SiLab-Bonn/BDAQ-core/README.md

# BDAQ Core board documentation 

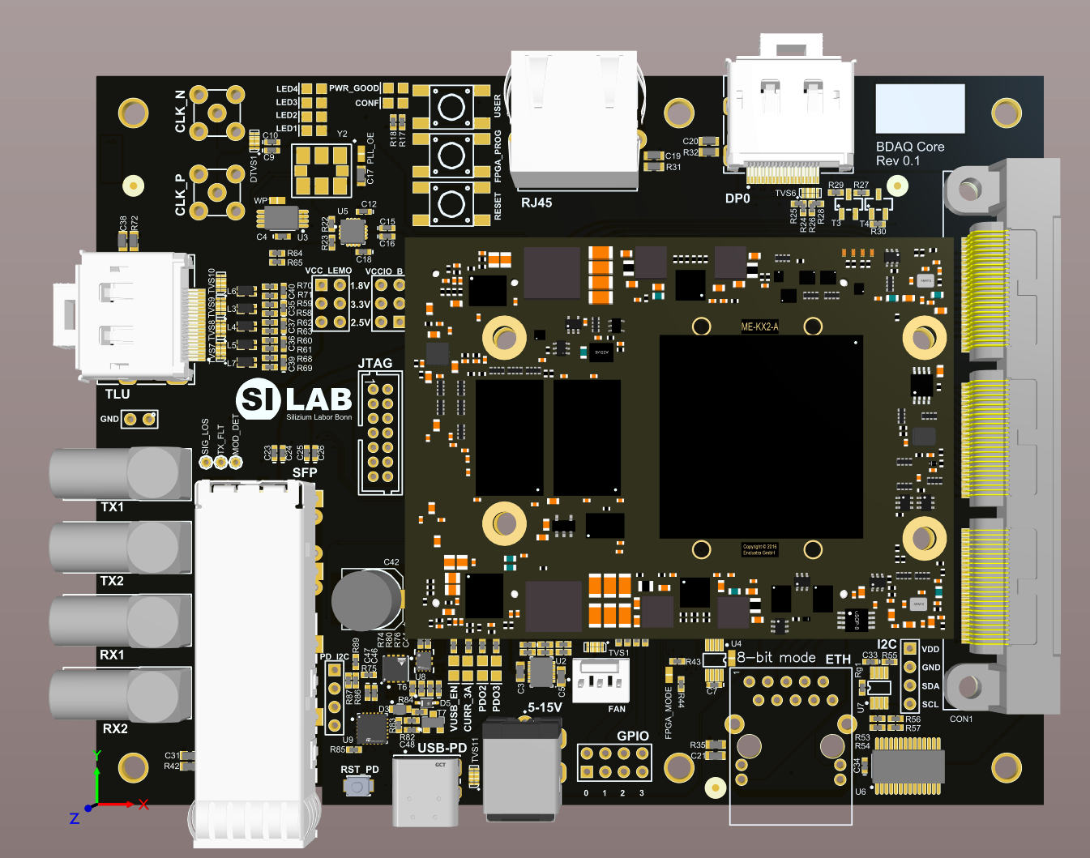
[picture p1: bdaq-core.png]
BDAQ Core board


Documentation will be made available here. The design files are accessible via the FTD Altium Cloud service.

Todo
- add/update user constraints file
- ...
