SiLab-Bonn/BDAQ-core/BDAQ Core 1.2.pdf

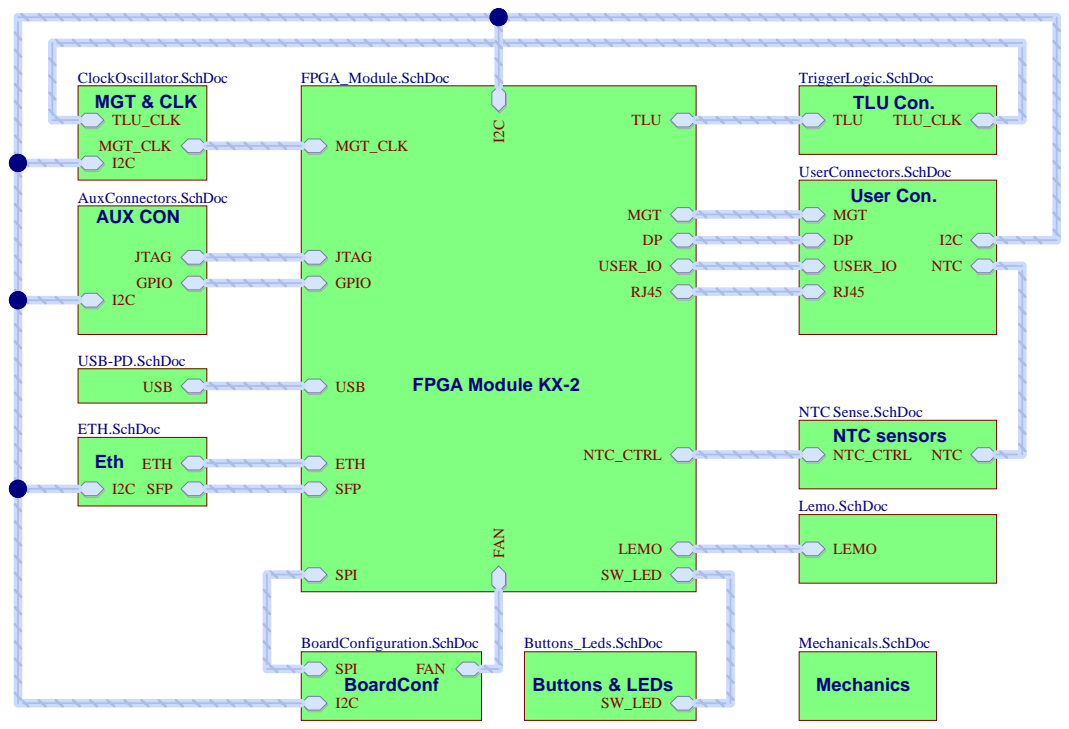
[picture p2: page 1]

Title: BDAQ Core | Physikalisches Institut UniversitätBonn Nußallee 12 53115 Bonn

Project: BDAQ Core | Drawn by:MV/HK/RL

Date: 11.09.2026 Time: 13:43:38 | Sheet of

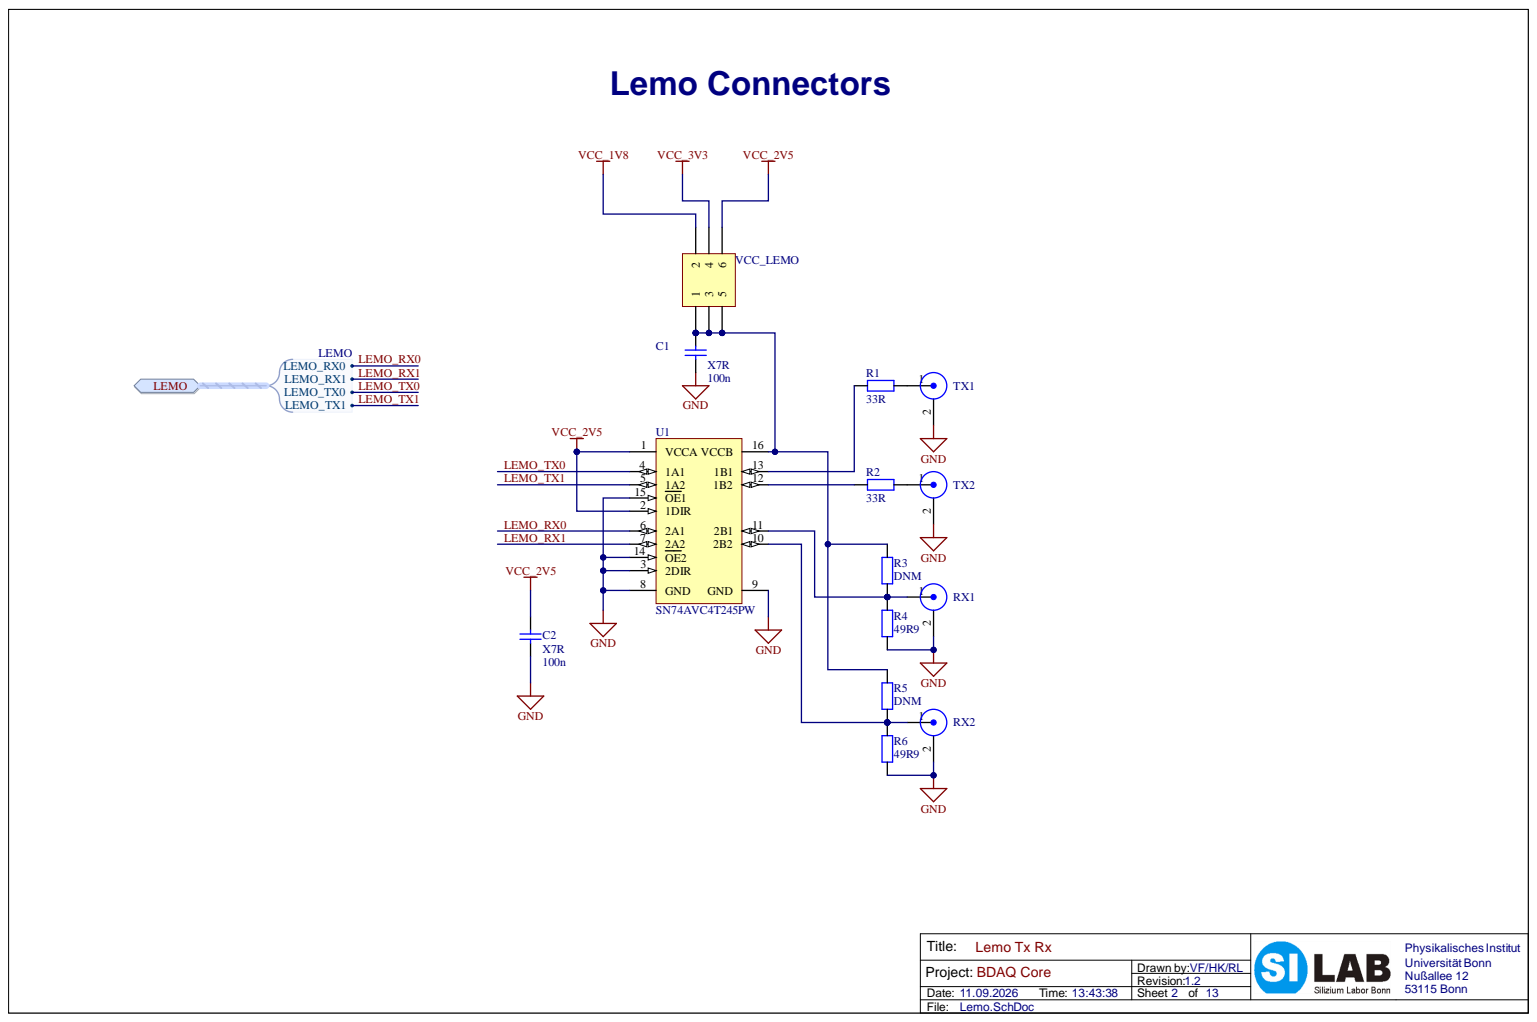
[picture p3: page 2]

Title: Date: File: P roject: BDAQ Cor e | Drawn by :VF / H K/ R L

Lemo Tx Rx | Phy sikalis ches Ins t i t u t 53115 Bonn UniversitätBonn N u ßallee 12

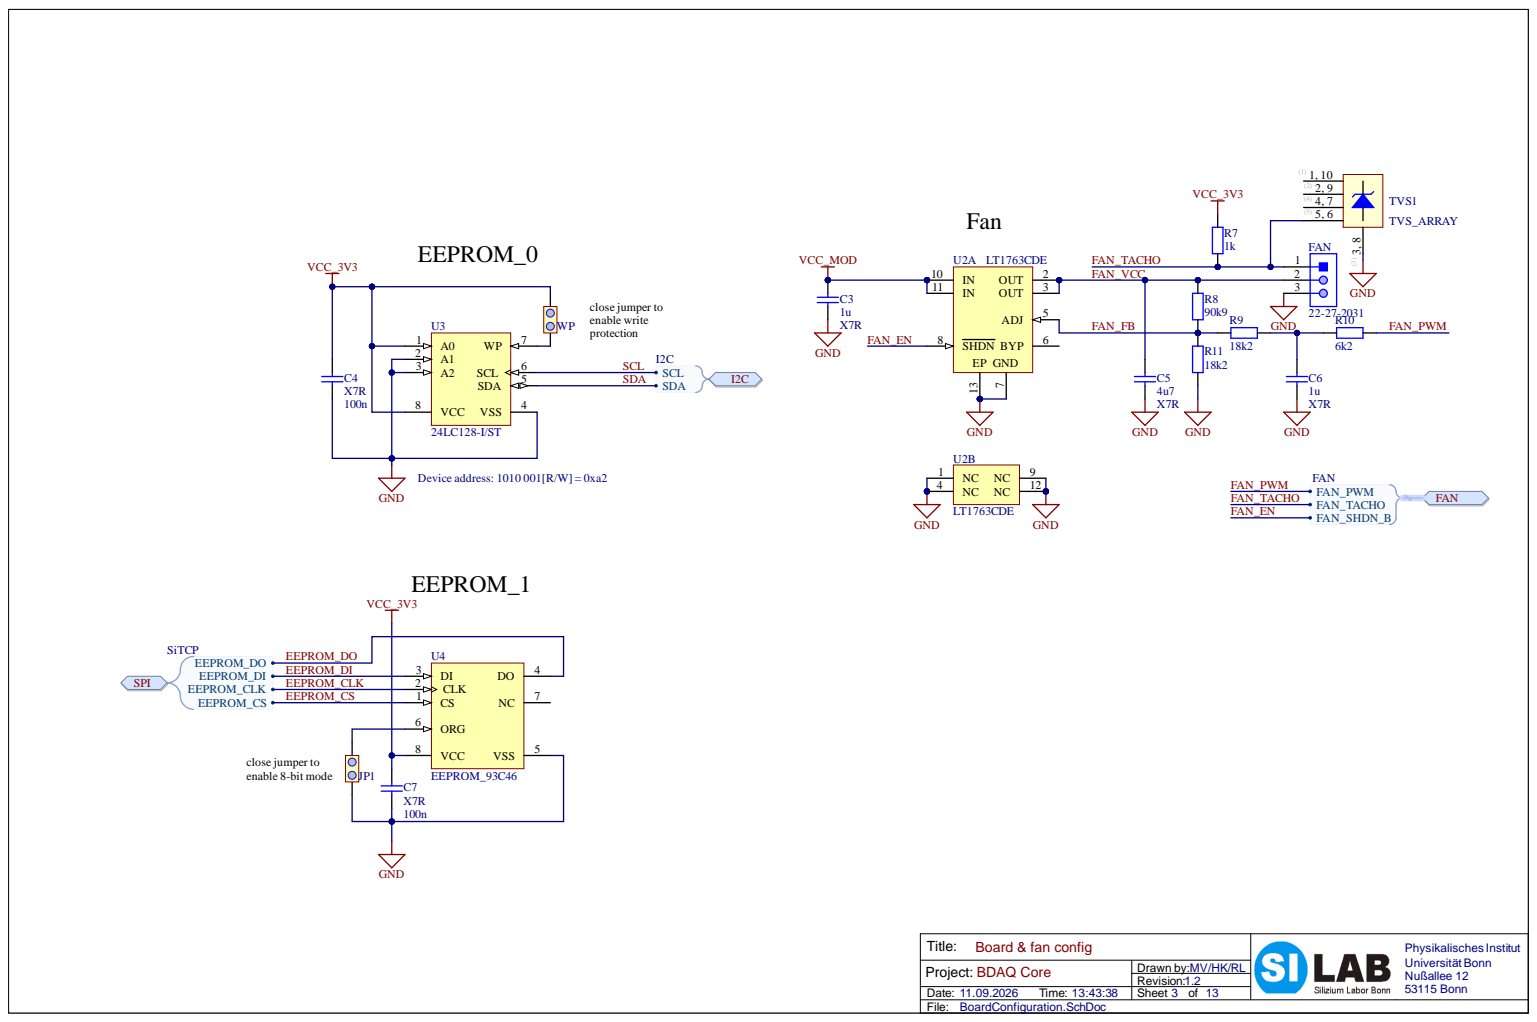
[picture p4: page 3]

Title: Board & fan config | Physikalisches Institut UniversitätBonn Nußallee 12 53115 Bonn

Project: BDAQ Core | Drawn by:MV/HK/RL

Date: 11.09.2026 Time: 13:43:38 | Sheet of

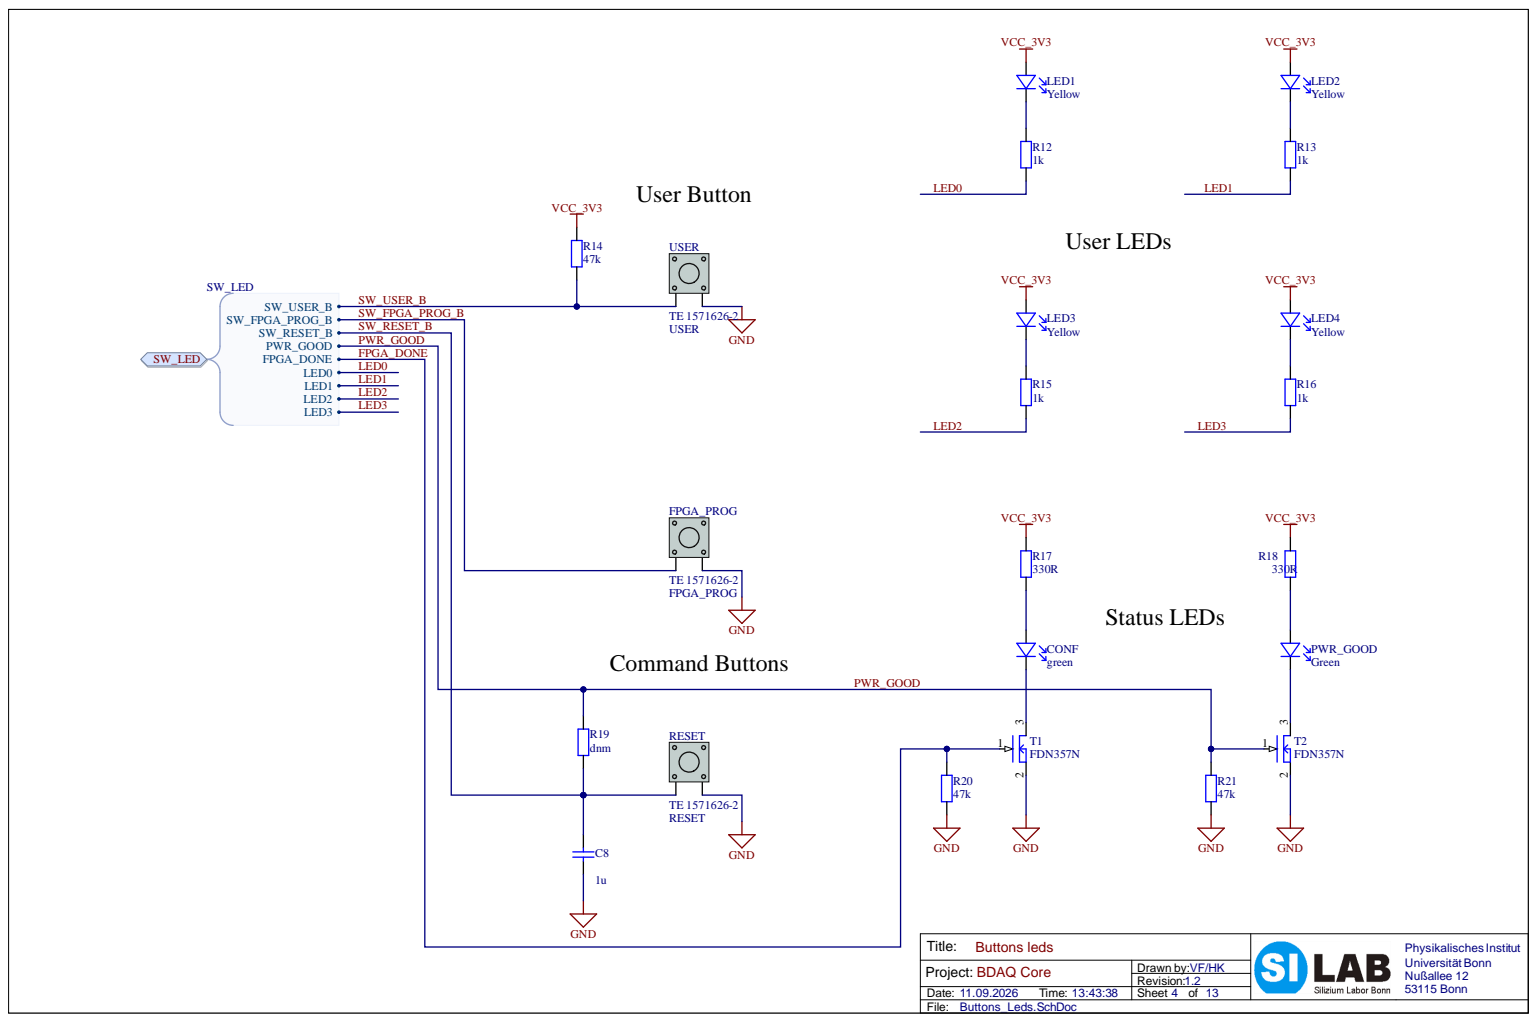
[picture p5: page 4]

Title: Date: File: P roject: BDAQ Cor e | Drawn by :VF / H K

Buttons leds | Phy sikalis ches Ins t i t u t 53115 Bonn UniversitätBonn N u ßallee 12

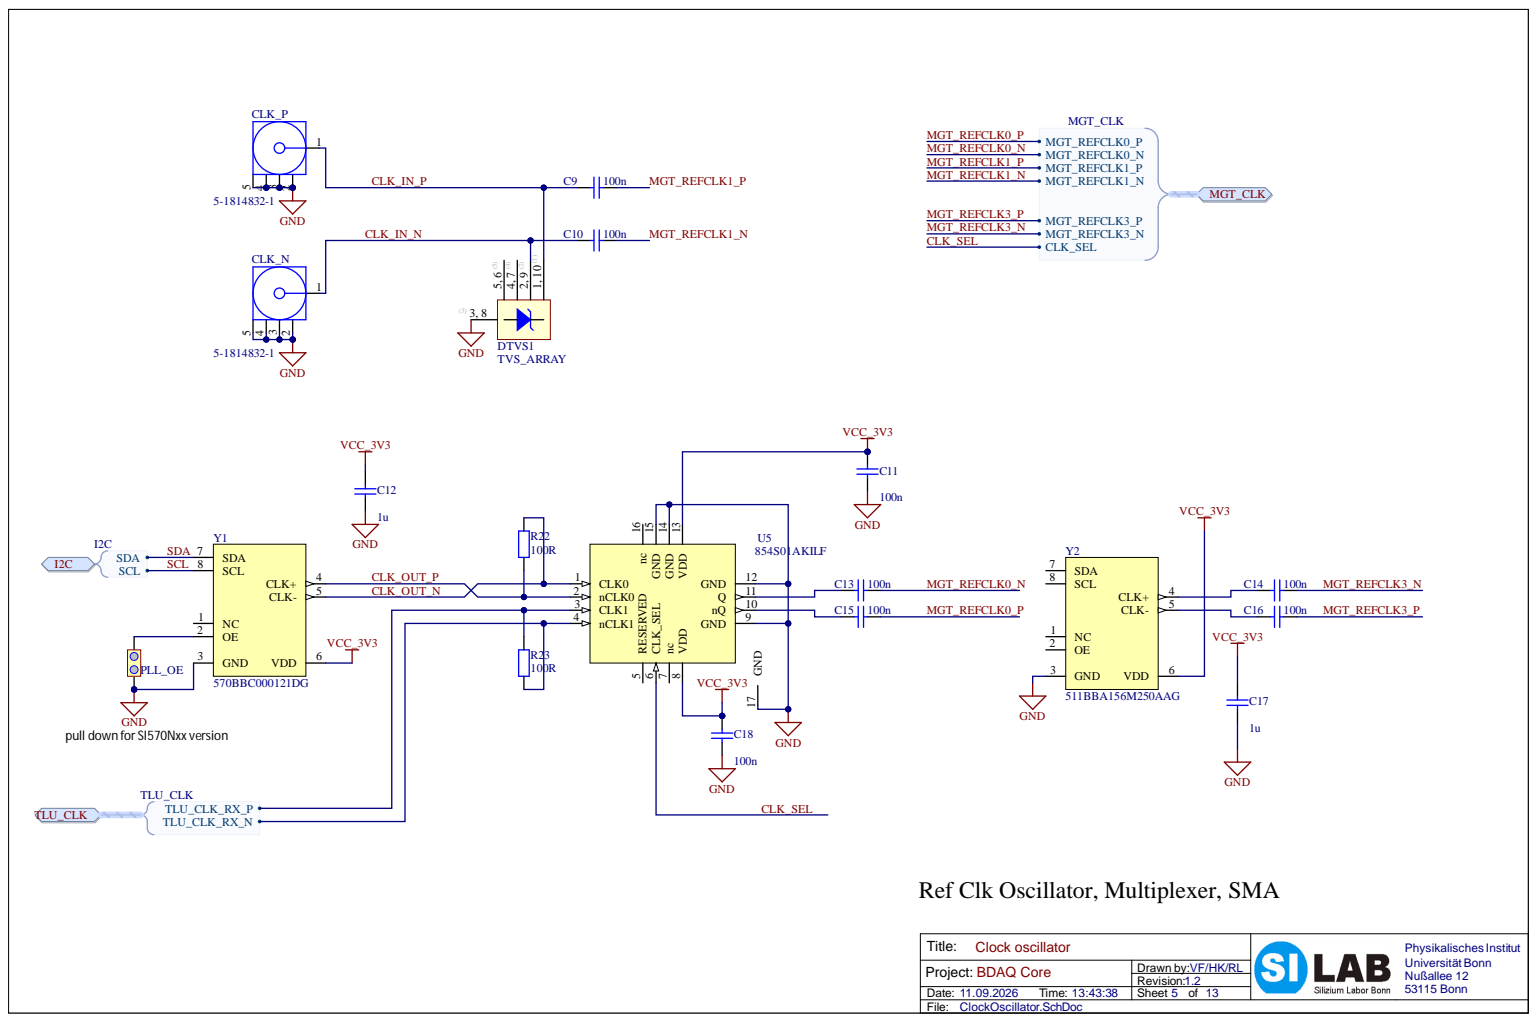
[picture p6: page 5]

12 DD 13 GND 14 GND 15 nc 16

pull down for SI570Nxx version

Ref Clk Oscillator, Multiplexer, SMA

Title: Clock oscillator | Physikalisches Institut UniversitätBonn Nußallee 12 53115 Bonn

Project: BDAQ Core | Drawn by:VF/HK/RL

Date: 11.09.2026 Time: 13:43:38 | Sheet of

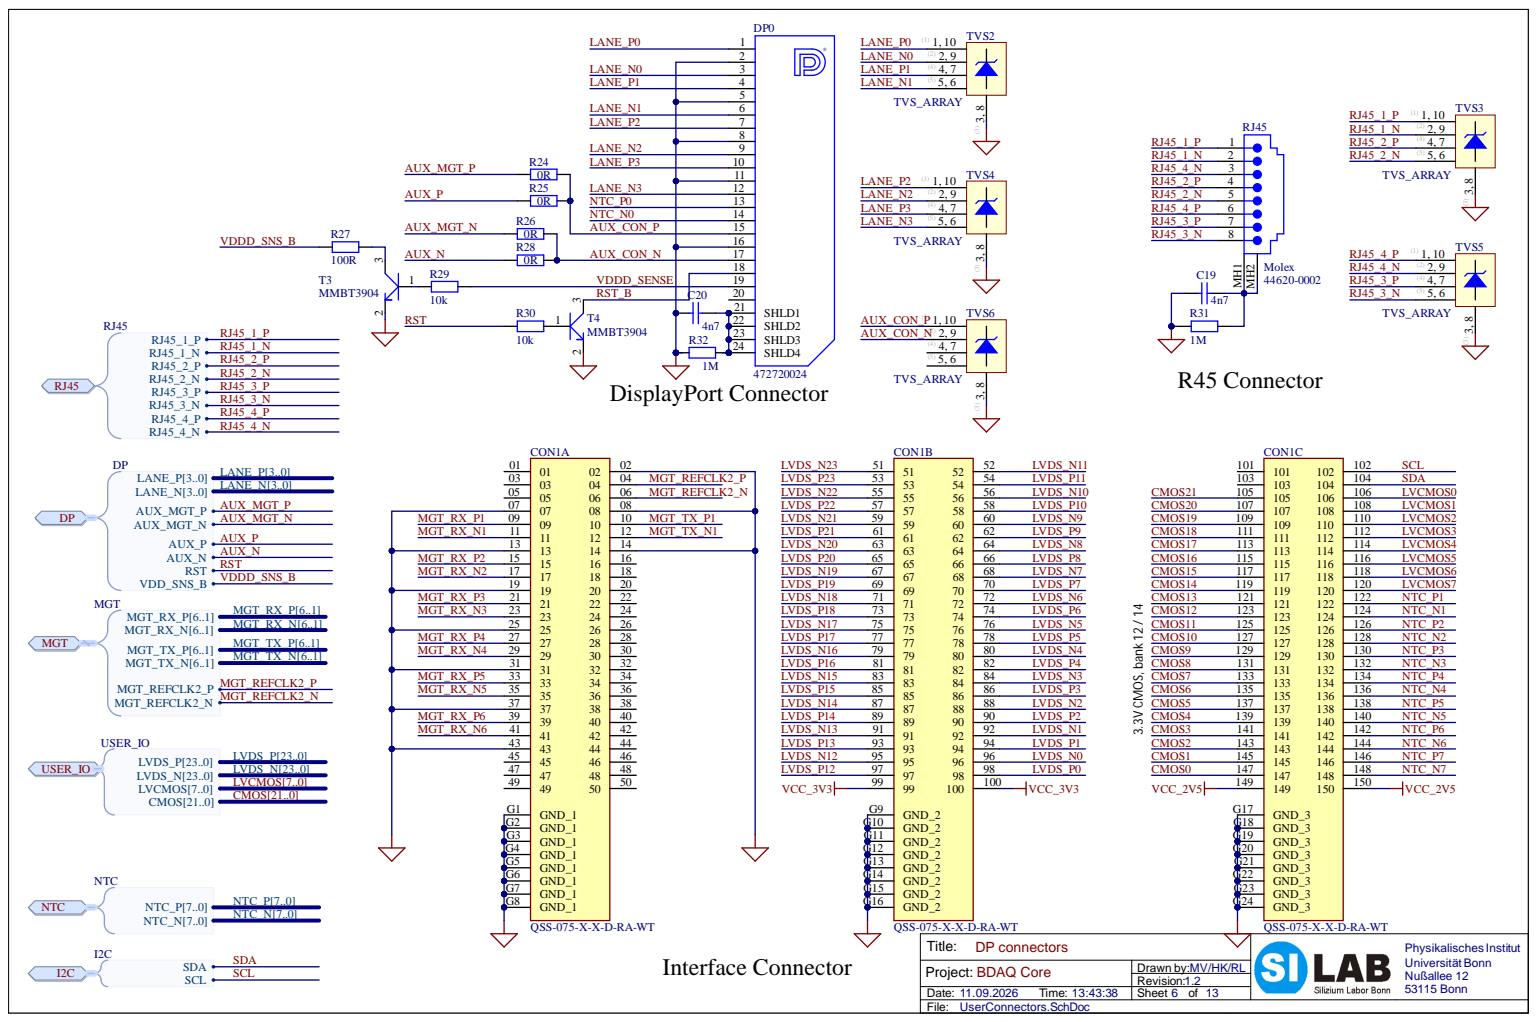
[picture p7: page 6]

1 7
1 8

V D D D _SE N S E | | 1 9
RST _B | C2 0 | 2 0

R3 | | 2 1
4 n 7 2 | 2 2

Title: Date: File: P roject: BDAQ Cor e | Drawn by : MV/ H K/ R L

DP connector s | Phy sikalis ches Ins t i t u t 53115 Bonn UniversitätBonn N u ßallee 12

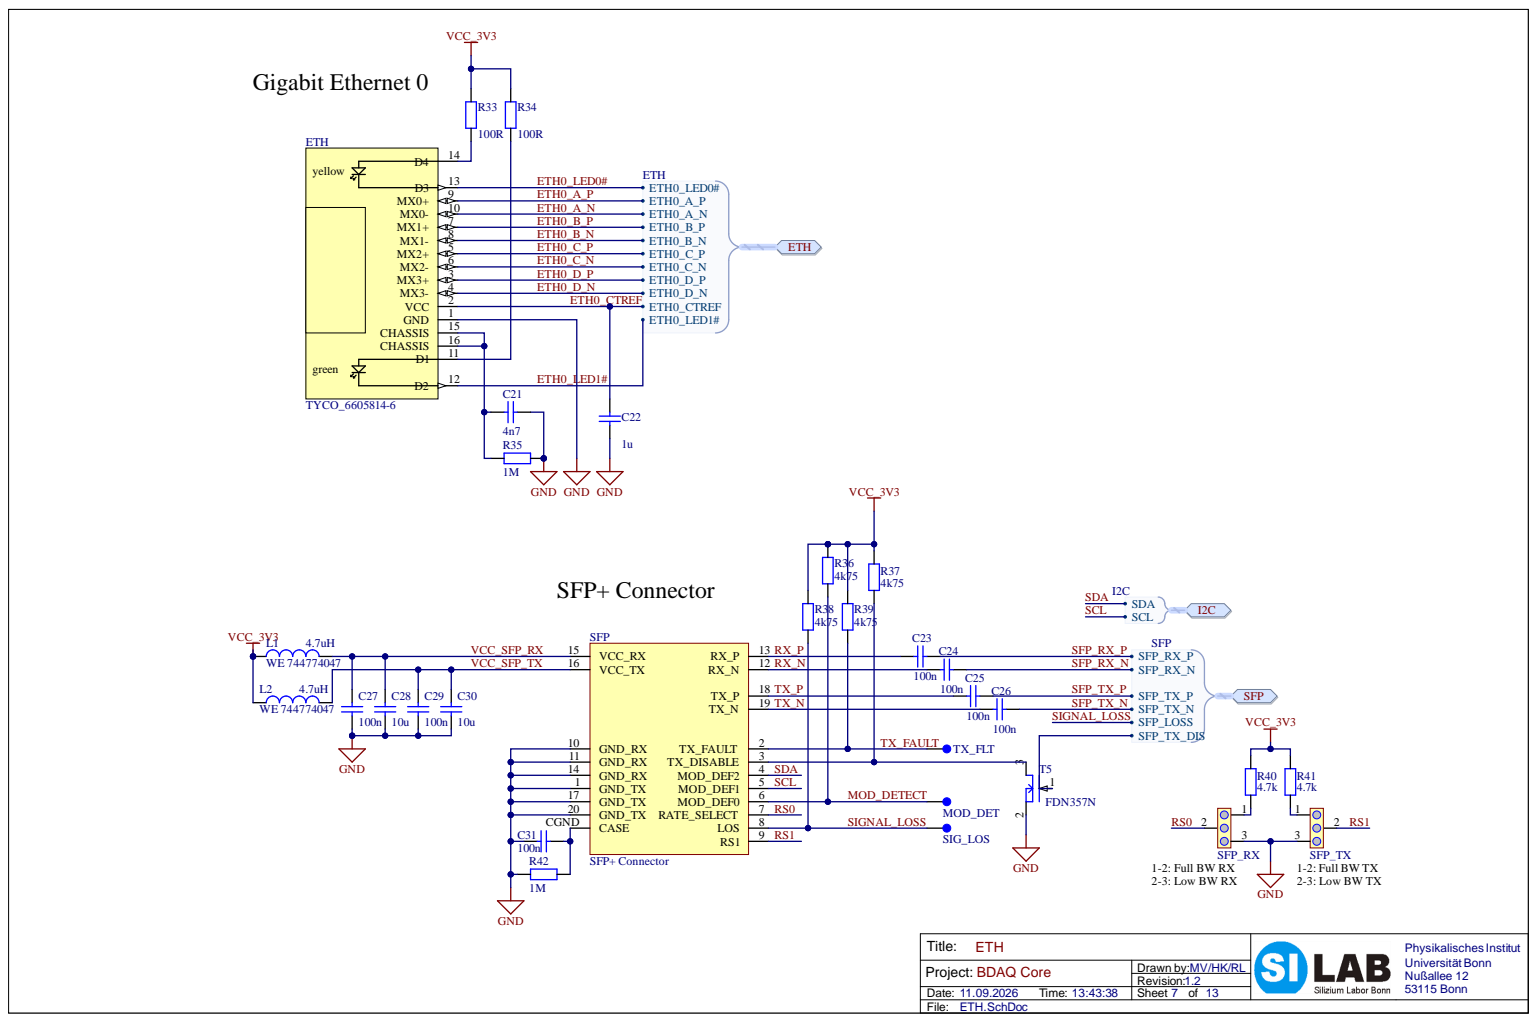
[picture p8: page 7]

yellow

ETH0_A_N
ETH0_B_P

ETH0_D_P
ETH0_D_N
ETH0_CTREF

Title: ETH | Physikalisches Institut UniversitätBonn Nußallee 12 53115 Bonn

Project: BDAQ Core | Drawn by:MV/HK/RL

Date: 11.09.2026 Time: 13:43:38 | Sheet of

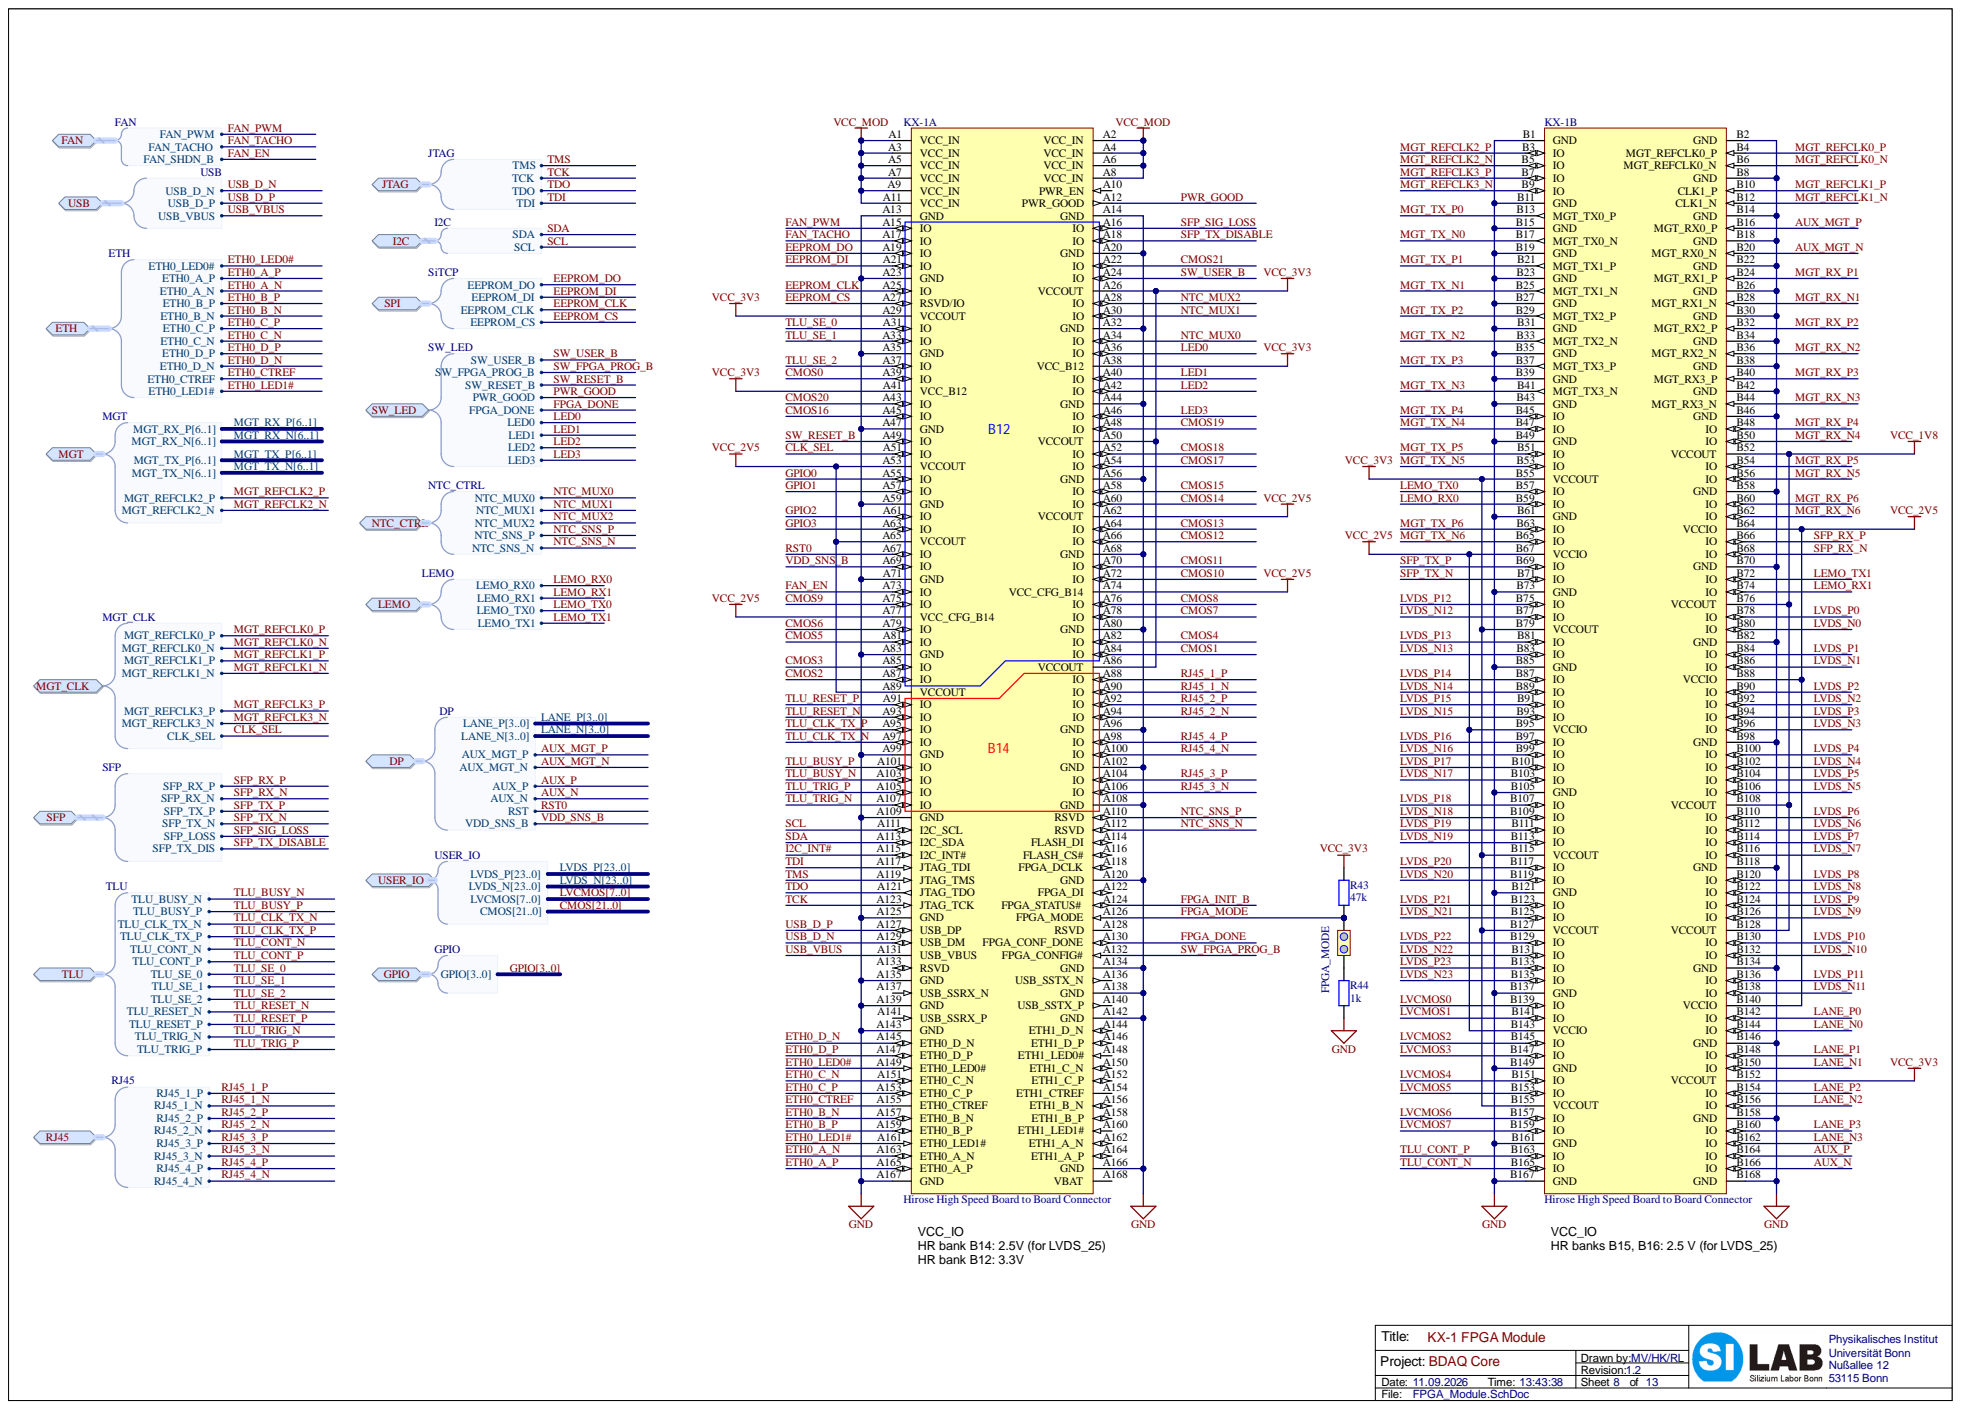
[picture p9: page 8]

A 3 | A | 4
A 5 | A | 6
A 7 | A | 8

A 9 | A10
A 1 | A12 A14

A76 A78 A80 | R J45_1_P R J45_1_N R J45_2_P R J45_2_N R J45_4_P R J45_4_N R J45_3_P R J45_3_N N T C_SNS_P N T C_SNS_N

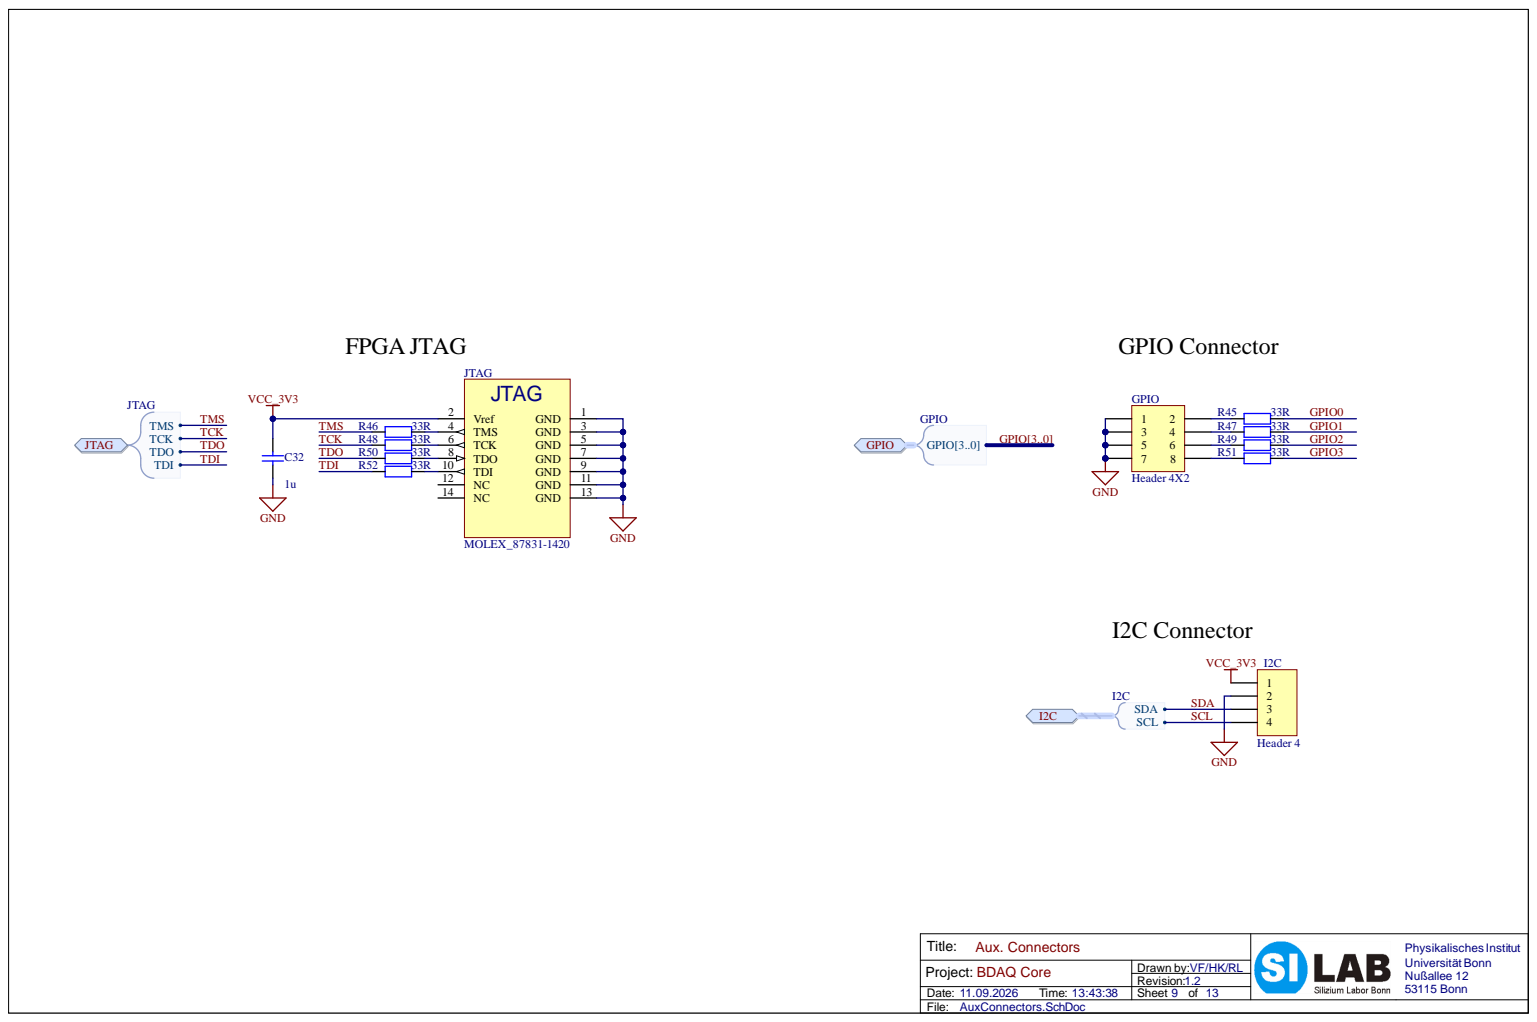
[picture p10: page 9]

Title: Aux. Connectors | Physikalisches Institut UniversitätBonn Nußallee 12 53115 Bonn

Project: BDAQ Core | Drawn by:VF/HK/RL

Date: 11.09.2026 Time: 13:43:38 | Sheet of

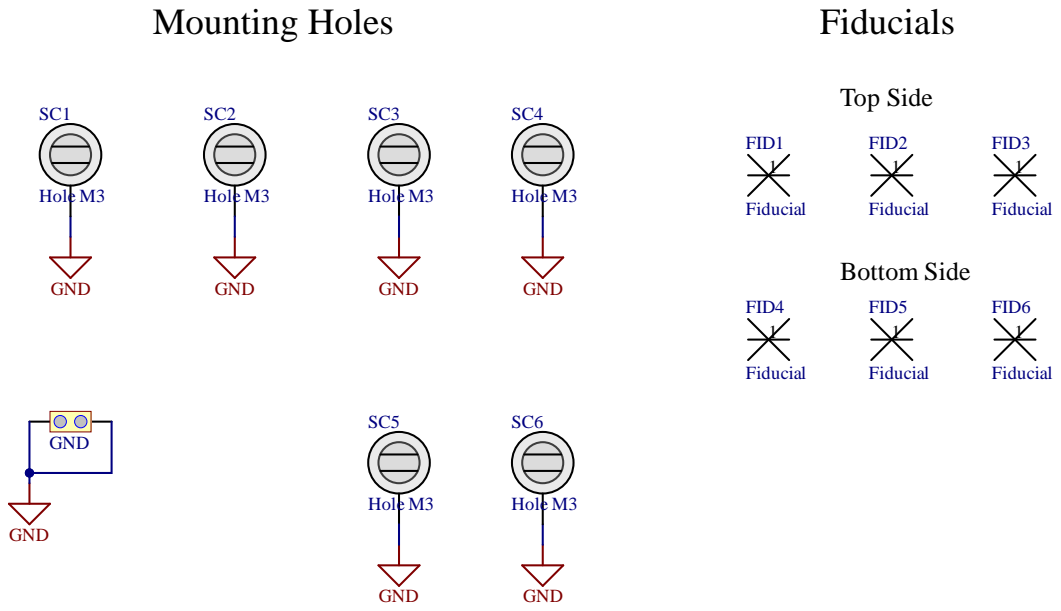
[picture p11: page 10]

Title: Mechanicals | Physikalisches Institut UniversitätBonn Nußallee 12 53115 Bonn
Project: BDAQ Core | Drawn by:VF/HK

Date: 11.09.2026 Time: 13:43:38 | Sheet of

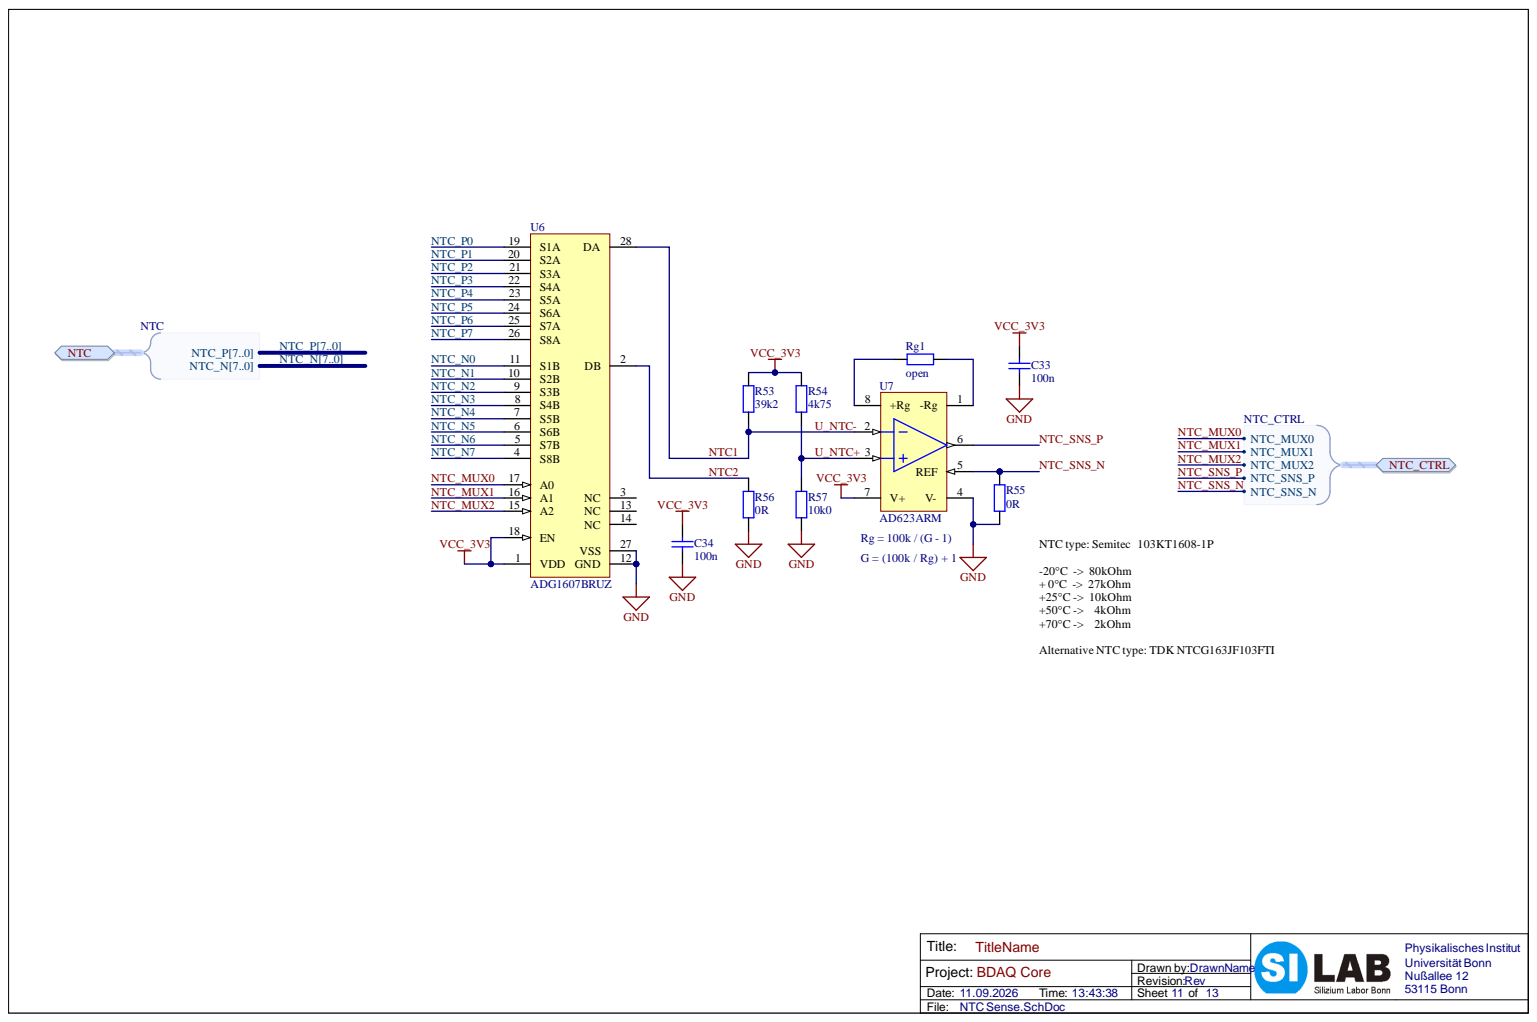
[picture p12: page 11]

Title: Date: File: P roject: BDAQ Cor e | Drawn by : DrawnN a m | e

TitleNam e | Phy sikalis ches Ins t i t u t 53115 Bonn UniversitätBonn N u ßallee 12

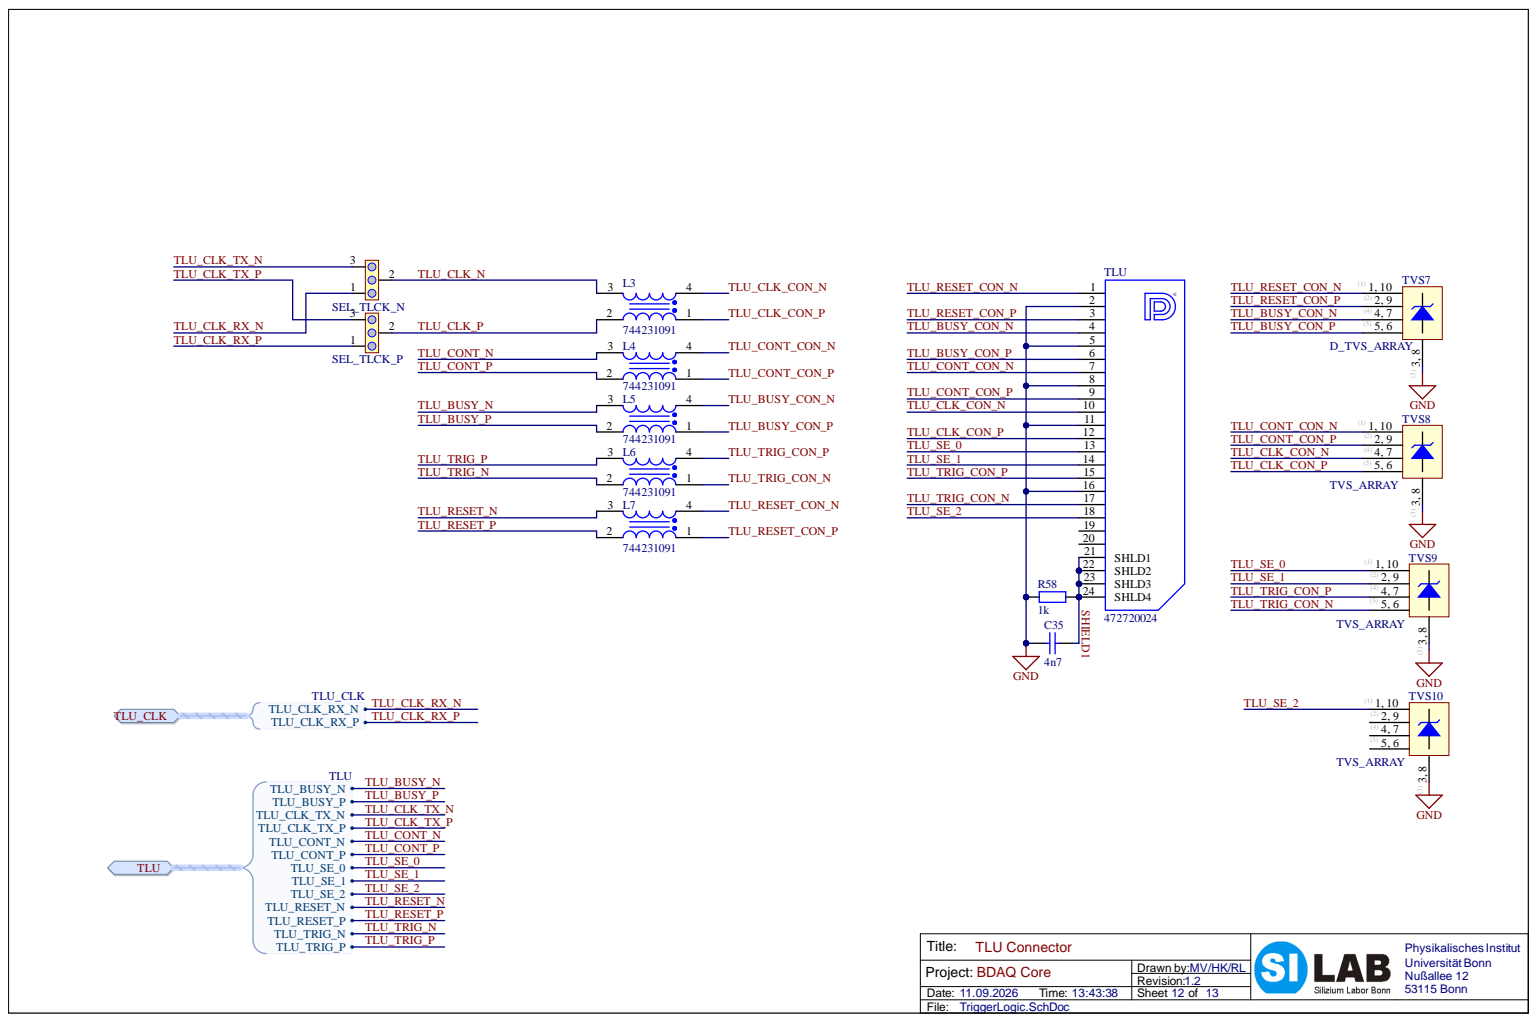
[picture p13: page 12]

Title: Date: File: P roject: BDAQ Cor e | Drawn by : MV/ H K/ R L

TLU Connector | Phy sikalis ches Ins t i t u t 53115 Bonn UniversitätBonn N u ßallee 12

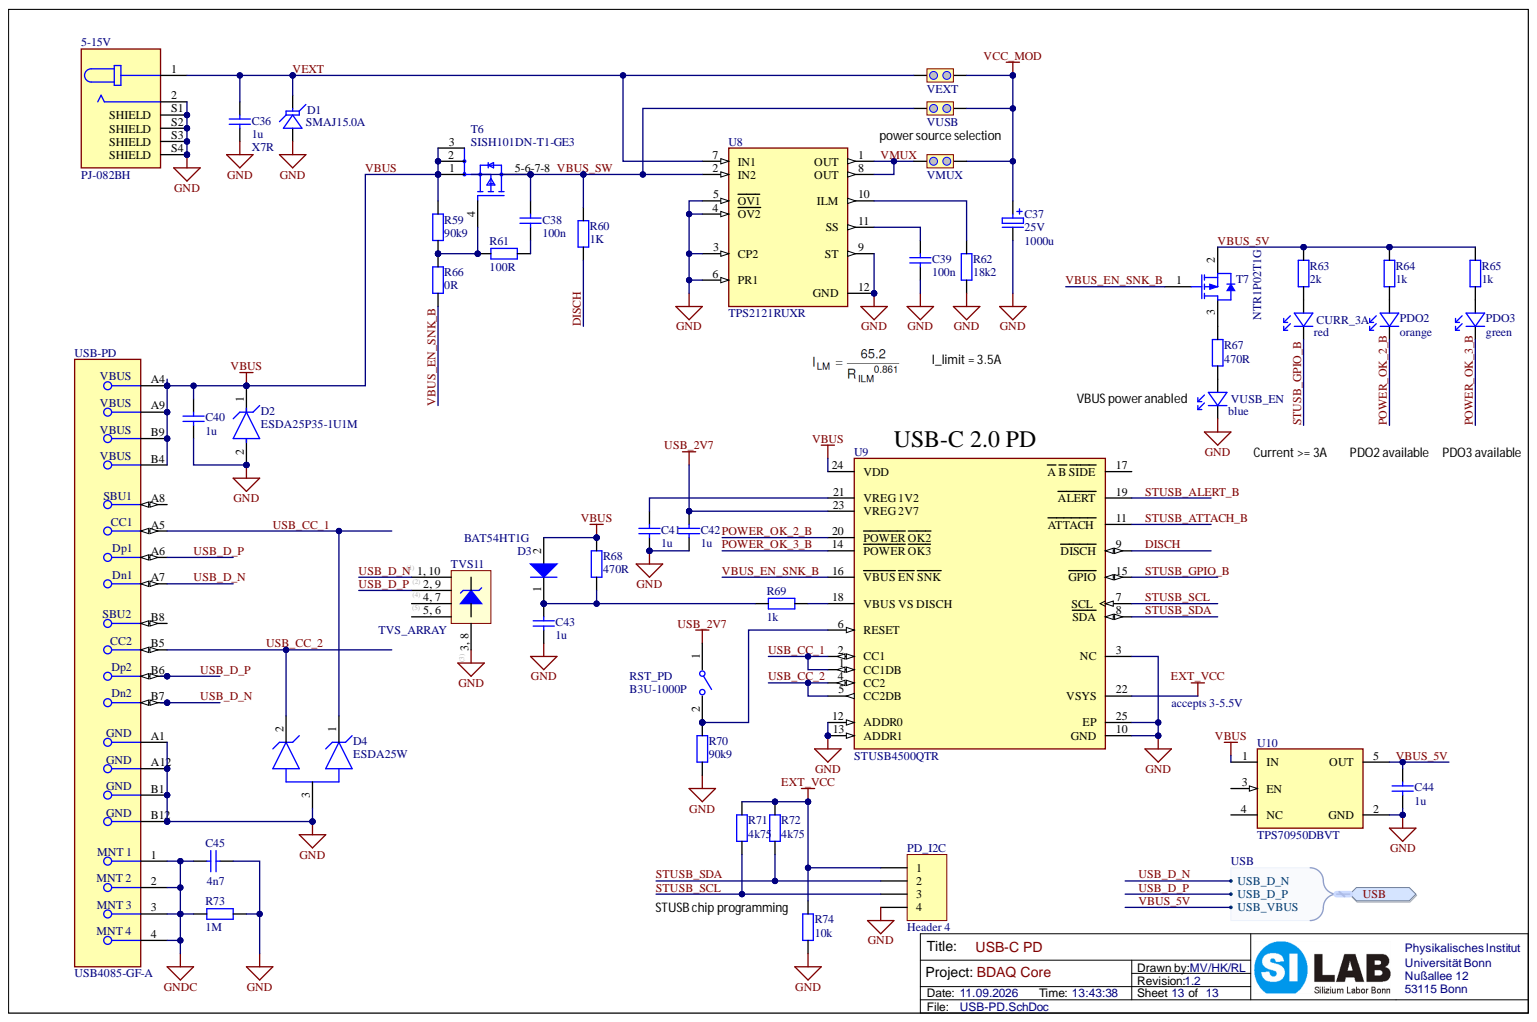
[picture p14: page 13]

Title: USB-C PD | Physikalisches Institut UniversitätBonn Nußallee 12 53115 Bonn

Project: BDAQ Core | Drawn by:MV/HK/RL

Date: 11.09.2026 Time: 13:43:38 | Sheet of

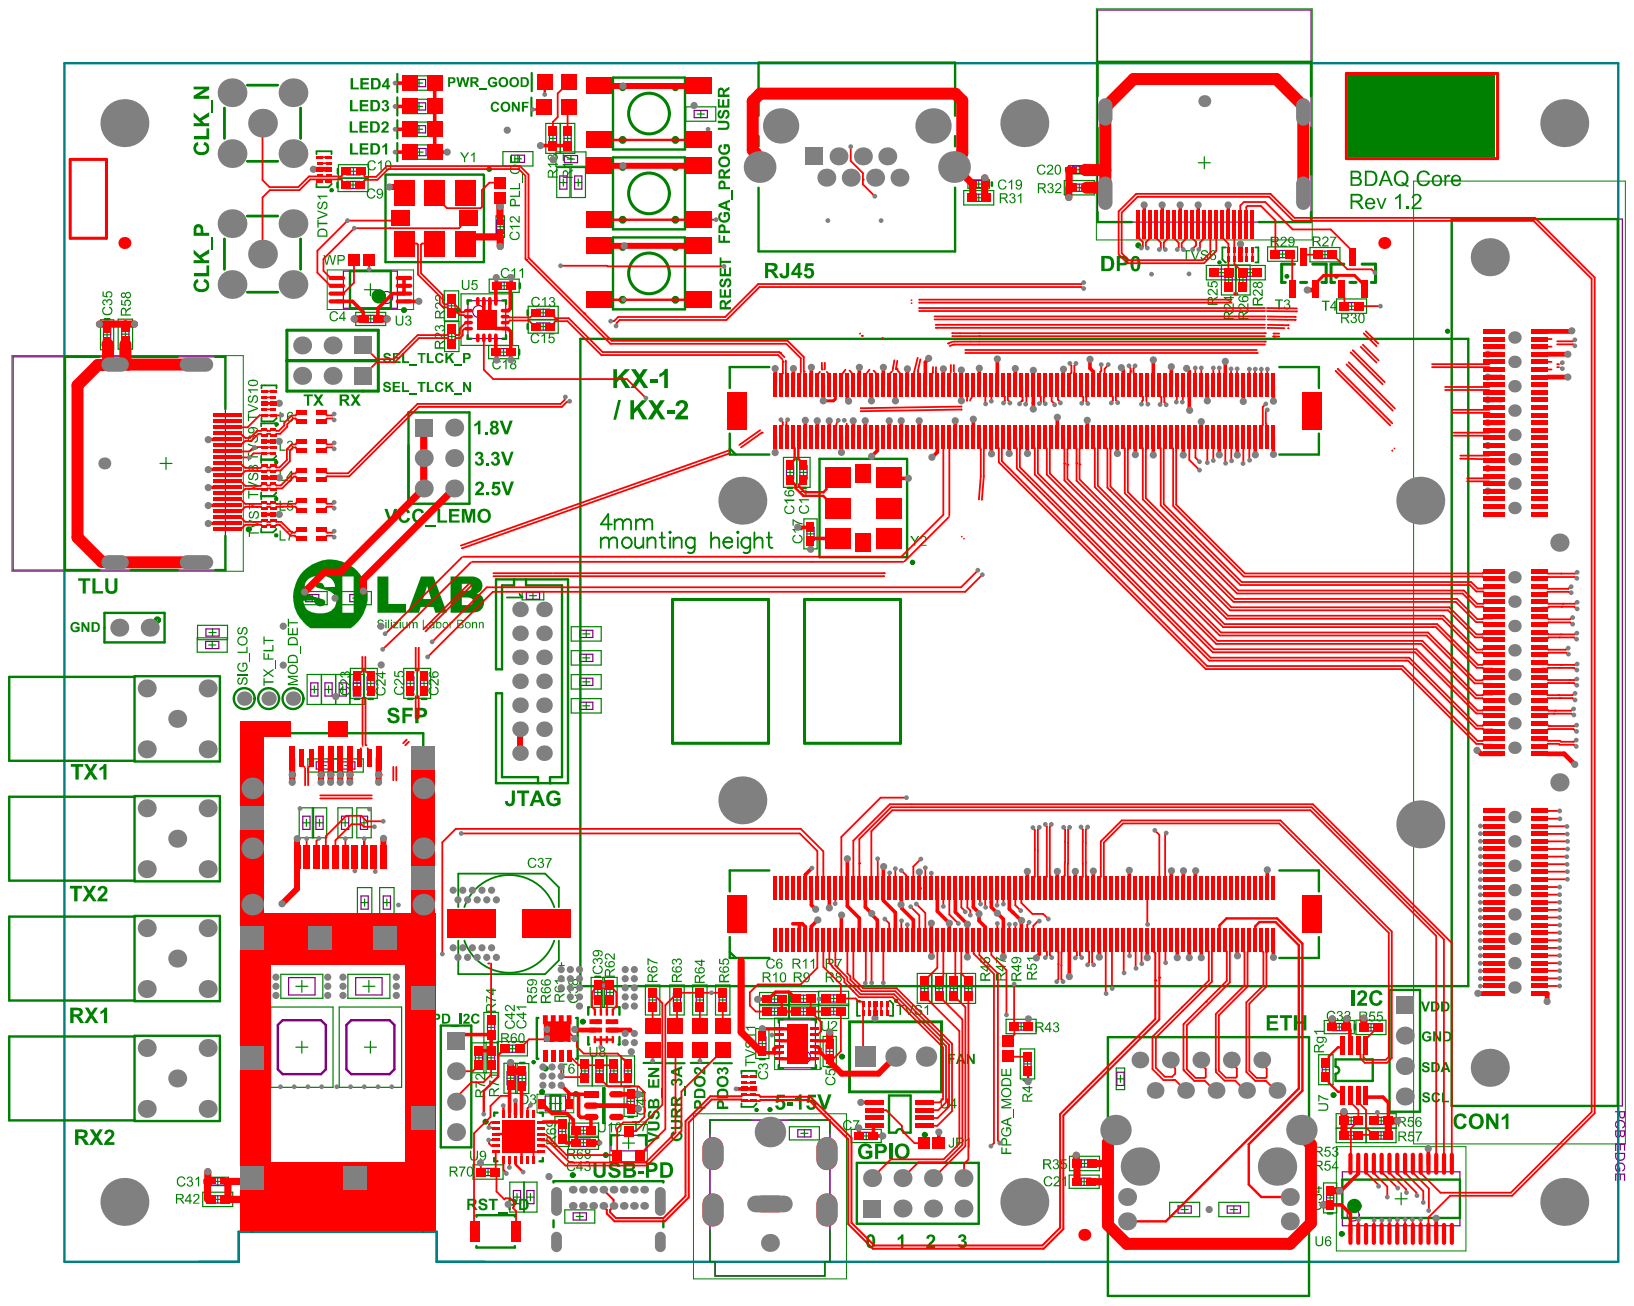
[picture p15: page 14]

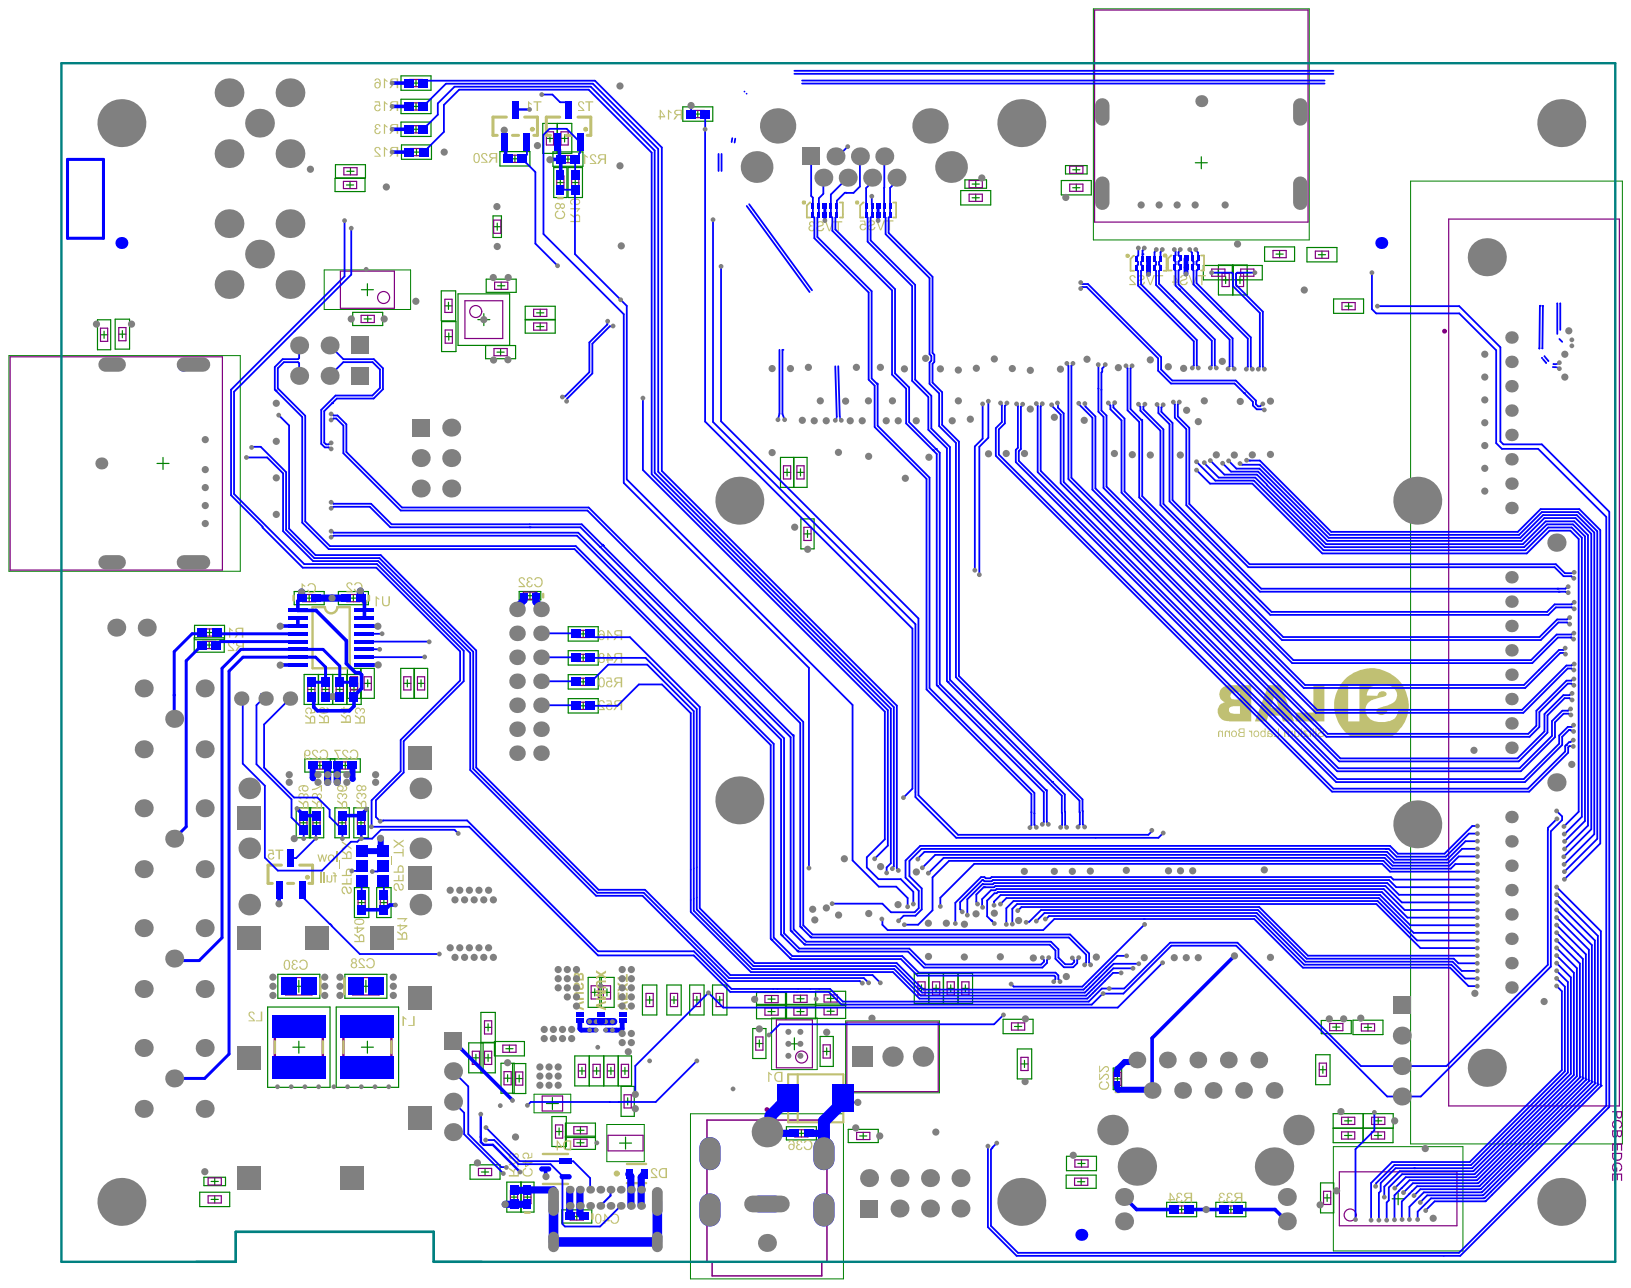
[picture p16: page 15]

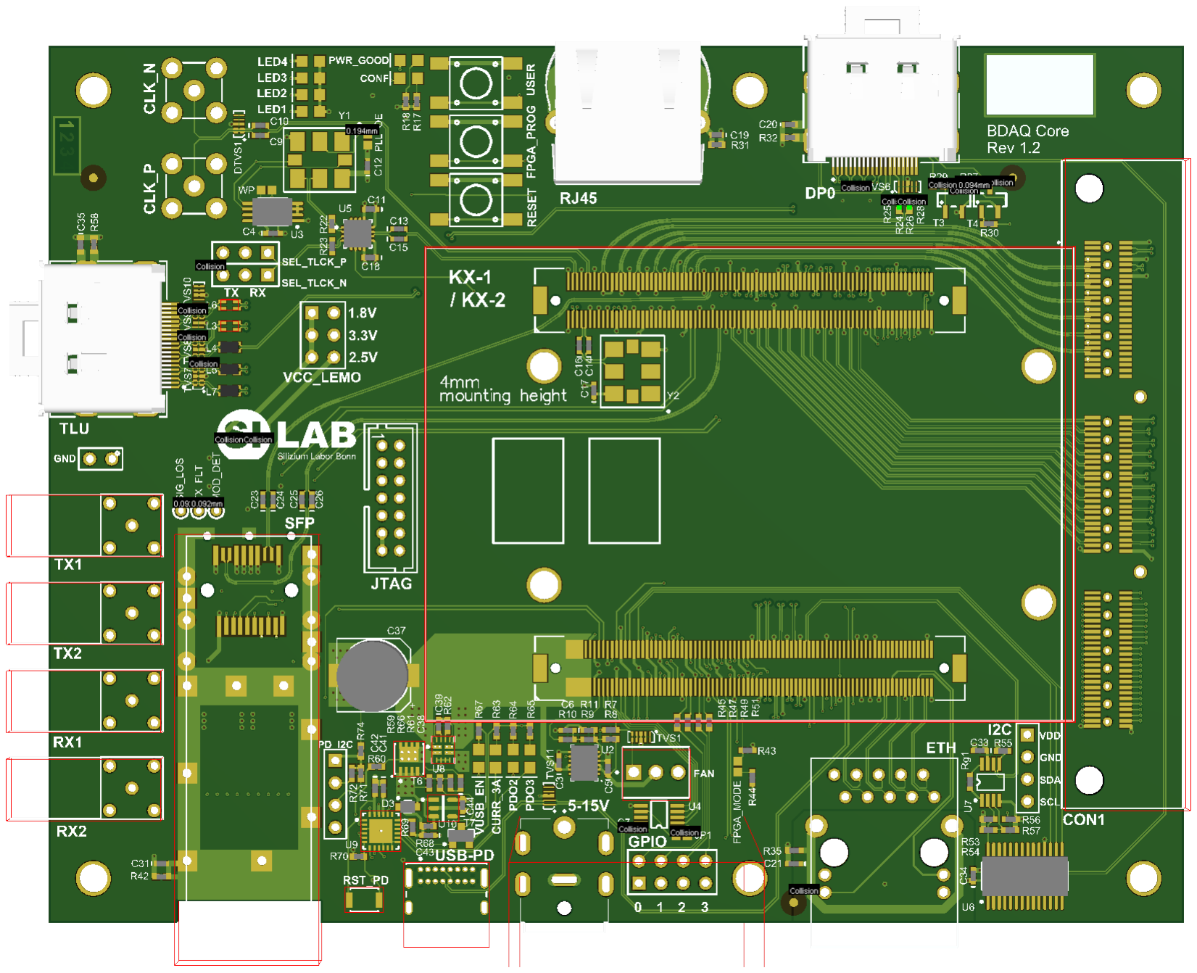
[picture p17: figure]
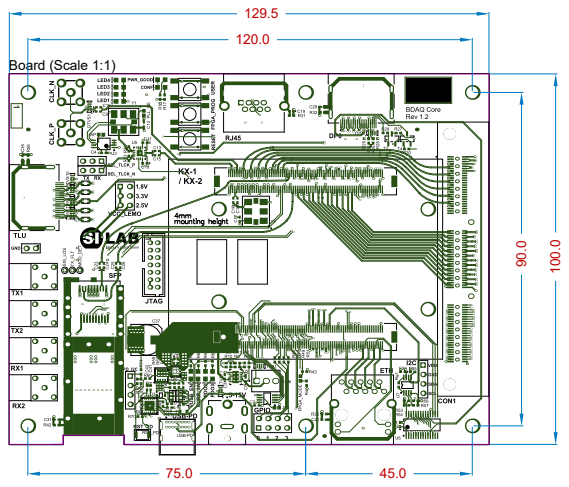
[picture p18: page 17]

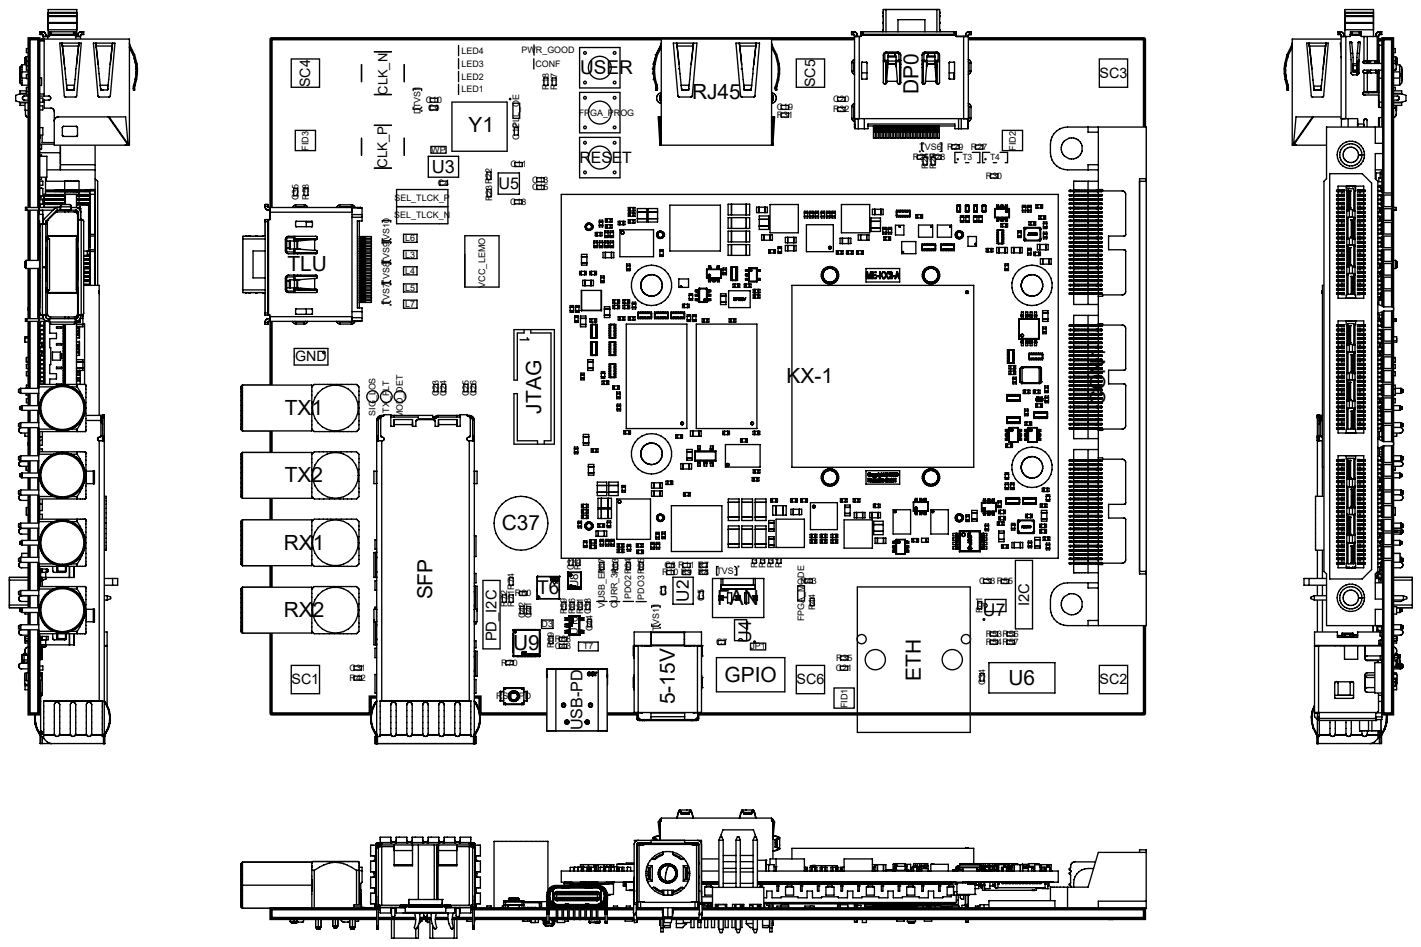
[picture p19: page 18]
