SiLab-Bonn/BDAQ-core/(commit log)

2025-11-05 inital commit
    [BDAQ core pin mapping.xlsx]
2025-11-05 Add README.md for BDAQ Core board documentation
    Initial documentation for BDAQ Core board.
2025-11-05 added xdc file from rev 2 board
